GAOTINGXIANG/MYCLASS/DOC/中文字模生成指南.md

# 中文字模生成指南

> 工具：https://lvgl.io/tools/fontconverter
> 目标：生成 **一颗 14px 中文字模**（含 ASCII），替换现有 Montserrat 14/24，
> 覆盖当前 UI + 全部规划游戏名 + 常用界面词，共 **161 个汉字 + 3 个符号**。
> 预计 Flash 占用：14px @ bpp4 ≈ 110B/字 → 161 字约 **18KB**（裕量 778KB，毫无压力）。

## 1. 网页参数设置

| 字段 | 填什么 | 说明 |
| --- | --- | --- |
| Name | `lv_font_cn_14` | 生成的字体变量名，代码里按此名引用 |
| Size | `14` | 唯一字号，与当前正文一致 |
| Bpp | `4` | 16 级灰度抗锯齿；圆屏小字务必用 4，勿选 1/2（锯齿明显） |
| TTF | `C:\Windows\Fonts\simhei.ttf`（黑体） | ⚠️ 雅黑 `msyh.ttc` 和宋体 `simsun.ttc` 是 TTC 合集，网页工具**解析不了**；黑体是单文件 TTF，笔画均匀适合小屏。若追求开源授权可换"思源黑体 Regular" |
| Range | `0x20-0x7F` | 完整 ASCII（数字/字母/常用符号），使英文界面与中文同字体 |
| Symbols | 见下方"字符集"整段复制 | 所有汉字 + ℃ ° ： |

输出格式保持默认（LVGL C 文件），点 **Convert** 下载 `lv_font_cn_14.c`。

## 2. 字符集（Symbols 字段整段复制）

```
℃°：温湿度雷达钟表指南针系统信息游戏贪吃蛇打砖块结束你赢了按确认键开始北东西校准运行时间内存占用距离错误失败最高分得生命卡暂停继续退出设置难剩余重帮助于版本俄罗斯方块数字华容道小恐龙跳跃地鼠大鱼坦克射击飞黄金矿工切水果五子棋豆电脑马奥滑雪冒险铁跑酷狙外星旋转赛泡堂台球青蛙祖玛植物战僵尸保卫萝卜愤怒的鸟中国象棋羽毛火柴格斗冰菜
```

**覆盖清单**（缺字会显示方块，发现后把缺的字追加进 Symbols 重新生成即可）：

- 主菜单/游戏名：温湿度、雷达、钟表、指南针、系统、游戏、贪吃蛇、打砖块、
  俄罗斯方块、数字华容道、扫雷、小恐龙跳跃、打地鼠、大鱼吃小鱼、坦克射击、
  飞行射击、黄金矿工、切水果、五子棋、打豆豆、电脑鼠、
  马里奥、滑雪大冒险、地铁跑酷、狙击外星人、旋转赛车、泡泡堂、台球、
  青蛙祖玛、植物大战僵尸、保卫萝卜、愤怒的小鸟、中国象棋、羽毛球、
  火柴格斗、冰火人、种菜
- 界面提示：游戏结束、你赢了、按确认键开始、校准、错误、失败
- 标签词：温度、湿度、距离、运行时间、内存占用、最高分、得分、生命、
  关卡、暂停、继续、退出、设置、速度、难度、剩余、重开、帮助、关于、版本
- 方位：北、东、南、西
- 特殊符号：℃（温度单位）、°（指南针角度）、：（全角冒号）

## 3. 生成后接入步骤（我来执行）

1. `lv_font_cn_14.c` 放入 `LVGL_BSP/font/`，加入 Keil（LVGL_BSP 组）
2. 新建 `lv_font_cn.h`：`LV_FONT_DECLARE(lv_font_cn_14);`
3. `lv_conf.h`：
   - `LV_FONT_DEFAULT` → `&lv_font_cn_14`
   - `LV_FONT_MONTSERRAT_14` 置 0；`_24` 按实际情况（DEMO 组 demo_sensor.c 在用则保留）
   - `LV_USE_FONT_COMPRESSED` 置 1（在线工具默认压缩输出，否则黑屏）
   - `LV_USE_FONT_SUBPX` 置 1（生成时带亚像素/`--lcd` 则必须，否则文字不绘制）
4. 启动器等原 24px 大字处改为 `lv_font_cn_14`
   （视觉上变小；如需大字效果，可用 `lv_obj_set_style_transform_zoom(label, 512, 0)` 做 2 倍缩放，代价是像素感）
5. 字符串替换为中文，**含中文的 .c 文件必须保存为 UTF-8 with BOM**
   （Keil AC5 无 BOM 会按 GBK 解释，屏幕显示乱码）

## 4. 常见问题

| 现象 | 原因 / 处理 |
| --- | --- |
| 网页上传 TTF 报错 | 用了 .ttc 合集，换 simhei.ttf 或思源黑体 .otf/.ttf |
| 屏幕显示方块 | 该字不在 Symbols 里，把缺字追加后重新生成替换 .c |
| 屏幕显示乱码（全部中文） | 源文件不是 UTF-8 with BOM，用编辑器另存为带 BOM |
| 中文显示但英文变了 | 正常现象：英文数字也来自新字模，风格统一 |
| 编译报错 `struct "_lv_font_t" has no field "static_bitmap"` | 在线工具按新版 LVGL 生成，8.3 的 `lv_font_t` 无此字段，删除 `.static_bitmap = 0,` 一行即可 |
| 编译报错找不到 `lvgl/lvgl.h` | Keil AC5 不支持 `__has_include`，把字模头部的包含判断块整体改为 `#include "lvgl.h"` |
| **烧录后屏幕全黑，但蜂鸣/摇杆/编码器正常** | 字模是压缩格式（`.bitmap_format = 1`）而 `LV_USE_FONT_COMPRESSED = 0`，每个字符位图都返回 NULL → 全部跳过绘制。该宏置 1 即可；或重新生成时取消 Compress 并把宏改回 0 |
| 文字一律不绘制（图形正常） | 字模带亚像素（`--lcd`，`.subpx = LV_FONT_SUBPX_HOR`）而 `LV_USE_FONT_SUBPX = 0`；置 1 |
| 中文/英文有红蓝彩边 | 亚像素方向与屏幕 RGB 排列不匹配，翻转 `lv_conf.h` 的 `LV_FONT_SUBPX_BGR`（0↔1） |
| **Keil 报 `missing closing quote` 且字符串显示成 `灏忔亹榫欒烦璺?`** | 文件丢了 UTF-8 BOM（某些编辑/保存动作会剥掉 BOM），Keil 按 GBK 解释导致中文字符串被截断。重新另存为 **UTF-8 with BOM** 即可；**每次改完带中文的字符串都要复查 BOM** |

## 5. 缺失汉字清单（已补齐）

当前字模为一次性在线生成，**缺字会显示成方块**。发现缺字时，把下面的字追加到网页 **Symbols** 框，
重新 Convert 生成整颗字模替换 `LVGL_BSP/lv_font_cn_14.c` 即可（不要手工往 .c 里插字——三张表
`glyph_bitmap / glyph_dsc / unicode_list` 必须严格对齐，手工插字极易错位）。

> 核查时间 2026-11-01：新增「说明」栏目、「音效」开关，以及 9 个新游戏（大鱼小鱼/坦克射击/
> 黄金矿工/切水果/飞行射击/滑雪冒险/台球/地铁跑酷/狙击外星）后，重新扫描 `APP/*.c` 的全部
> 界面字符串（已排除注释），与现有字模 `unicode_list` 比对，**共 133 字缺失**。
>
> **2026-11-01 已补齐**：新生成字模（`unicode_list` 共 296 项）已替换 `LVGL_BSP/lv_font_cn_14.c`，
> 重新比对全部工程源码（244 个去重汉字）**缺字 0**。下面是当时的记录，留作以后补字参考。

### 5.1 一次性补字串（已并入新字模，留作记录）

```
一三上下不也人会传位作入关再减刀到刷刻加动十单即厘变可右同后向启周器回固声多完定左常平弹归彩快感或手才扣扫抓挥换掉推摆摇撞操效敌新明显朝机杆条枪树样模正每波洞清灯炮炸点照白盘瞄码碍碰示秒移空米类级编能自活落蜂补被说调起超越躲车轮近返进远速都钩锋锤长闭随障零静靠音页鸣默
```

### 5.2 逐字对照

| 来源 | 汉字（Unicode） |
| --- | --- |
| 「说明」菜单名 | 说(U+8BF4) 明(U+660E) |
| 说明·操作页 | 编(U+7F16) 码(U+7801) 器(U+5668) 摇(U+6447) 杆(U+6746) 左(U+5DE6) 右(U+53F3) 上(U+4E0A) 下(U+4E0B) 返(U+8FD4) 回(U+56DE) 一(U+4E00) 级(U+7EA7) 单(U+5355) 操(U+64CD) 作(U+4F5C) 同(U+540C) 样(U+6837) 进(U+8FDB) 入(U+5165) 换(U+6362) |
| 说明·指南针页 | 平(U+5E73) 模(U+6A21) 周(U+5468) 再(U+518D) 固(U+56FA) 定(U+5B9A) 朝(U+671D) 刻(U+523B) 盘(U+76D8) 随(U+968F) 位(U+4F4D) 动(U+52A8) 正(U+6B63) 蜂(U+8702) 鸣(U+9E23) 声(U+58F0) |
| 说明·小恐龙页 | 手(U+624B) 靠(U+9760) 近(U+8FD1) 超(U+8D85) 波(U+6CE2) 厘(U+5398) 米(U+7C73) 起(U+8D77) 到(U+5230) 才(U+624D) 能(U+80FD) 调(U+8C03) 速(U+901F) 加(U+52A0) 减(U+51CF) 推(U+63A8) 也(U+4E5F) |
| 说明·打地鼠页 | 传(U+4F20) 感(U+611F) 越(U+8D8A) 锤(U+9524) 移(U+79FB) 向(U+5411) |
| 说明·游戏页 | 类(U+7C7B) 或(U+6216) 灯(U+706F) 显(U+663E) 撞(U+649E) 扣(U+6263) 点(U+70B9) 归(U+5F52) 零(U+96F6) 即(U+5373) |
| 说明·音效页 | 音(U+97F3) 效(U+6548) 关(U+5173) 默(U+9ED8) 启(U+542F) 闭(U+95ED) 后(U+540E) 静(U+9759) 照(U+7167) 常(U+5E38) |
| 系统信息·音效行 | 音(U+97F3) 效(U+6548) 换(U+6362) 关(U+5173) 秒(U+79D2) |
| 小恐龙 HUD | 速(U+901F) |
| 「扫雷」菜单名 | 扫(U+626B) |
| 说明·大鱼小鱼页 | 三(U+4E09) 每(U+6BCF) 变(U+53D8) 长(U+957F) 碰(U+78B0) |
| 说明·坦克射击页 | 炮(U+70AE) 弹(U+5F39) 敌(U+654C) 被(U+88AB) |
| 说明·黄金矿工页 | 摆(U+6446) 钩(U+94A9) 抓(U+6293) 刷(U+5237) 完(U+5B8C) 新(U+65B0) |
| 说明·切水果页 | 刀(U+5200) 挥(U+6325) 锋(U+950B) 炸(U+70B8) 十(U+5341) 不(U+4E0D) 落(U+843D) |
| 说明·飞行射击页 | 机(U+673A) 自(U+81EA) |
| 说明·滑雪冒险页 | 树(U+6811) 躲(U+8EB2) 远(U+8FDC) 多(U+591A) |
| 说明·台球页 | 彩(U+5F69) 洞(U+6D1E) 白(U+767D) 瞄(U+7784) 可(U+53EF) 会(U+4F1A) 补(U+8865) 空(U+7A7A) 清(U+6E05) |
| 说明·地铁跑酷页 | 条(U+6761) 车(U+8F66) 轮(U+8F6E) 障(U+969C) 快(U+5FEB) 碍(U+788D) |
| 说明·狙击外星页 | 枪(U+67AA) 人(U+4EBA) 都(U+90FD) 掉(U+6389) |

> 注：旧记录曾把「雷」列为缺字，实际现有字模**已包含雷**（`unicode_list` 中偏移 0x9647 对应 U+96F7），
> 只有「扫」缺。若菜单显示「扫雷」时只有第一个字是方块，说明与此一致。

重新生成时把 5.1 整段粘贴进 Symbols，连同第 2 节已有字符一起生成，即可一次性补齐。
