GAOTINGXIANG/MYCLASS/DOC/游戏可行性评估.md

# 游戏可行性评估

> 评估对象：用户候选游戏清单（35 项，去重后）
> 硬件基线：STM32F407 @168MHz / 512KB Flash / 192KB RAM，240×240 圆屏（安全区为内接正方形 170×170，ORG=35），LVGL 8.3.11
> 输入：编码器（旋转+按键）、摇杆（模拟量+按键）、KEY1~KEY4、超声波 HC-SR04
> 输出：6×LED、蜂鸣器
> 框架：app_launcher（app_t 注册）+ game_common（生命值）+ sys_notify（声光）
> 美术约束：无图片素材，全部用几何图形 + 调色板表达

## 评估维度

1. **输入匹配**：编码器适合"光标/旋转/数值"，摇杆适合"方向/连续移动"，超声波适合"手势触发"
2. **屏幕适配**：网格类看格子能否放进 170×170；卷轴类看视野是否够用
3. **算力/内存**：F407 无压力于 2D 瓦片与简单物理；流体/刚体堆叠/复杂 AI 不行
4. **内容量**：几何风格能否表达玩法核心，是否需要大量剧情/素材
5. **框架契合**：能否直接挂 app_t，复用生命值/声光

---

## A 级：直接可做，适配良好

| 游戏 | 输入方案 | 布局 | 工作量 | 说明 |
|---|---|---|---|---|
| 俄罗斯方块 | 摇杆左右/下移，ENC 键旋转 | 10×20 格 @10px = 100×200 | 中 | 经典必做，圆屏竖向正好 |
| 2048 | 摇杆四方向滑动 | 4×4 @40px | 小 | 半天工作量，动画可省 |
| 数字华容道 | 摇杆滑动 / 编码器选格 | 4×4 @40px | 小 | 与 2048 同布局同输入 |
| 扫雷 | 编码器移光标，ENC 键翻开，KEY2 插旗 | 9×9 @16px | 小 | 编码器光标手感好 |
| **小恐龙跳跃** | **超声波：手一抬=跳**（距离突变检测） | 横版卷轴，几何仙人掌 | 小 | ⭐差异化亮点，输入创意 |
| **打地鼠** | **超声波：手拍下=锤**（距离变短触发） | 3×3 洞 @50px | 小 | ⭐差异化亮点 |
| 大鱼吃小鱼 | 摇杆游动 | 全屏水域 | 小 | 成长反馈好做（体型+LED） |
| 坦克射击 | 摇杆移动，JS 键开炮 | 12×12 tile @14px | 中 | 坦克大战简化版：砖墙+基地+3 种敌坦 |
| 飞行射击 | 摇杆移动，自动开火 | 纵版卷轴 | 中 | 雷霆战机简化：子弹池+敌机编队 |
| 黄金矿工 | 爪子自动摆动，任意键放爪 | 上爪下矿 | 中 | 简谐摆动+线段数学，物理简单 |
| 切水果 | 摇杆控制刀光轨迹 | 全屏 | 中 | 水果抛物线+线段切割判定 |
| 五子棋 | 编码器+摇杆选点，ENC 落子 | 13×13 @13px | 小(双人)/中(AI) | AI 用计分表即可，不求强 |
| 打豆豆 | 编码器选格，ENC 消除 | 8×8 @20px | 小 | 点击相邻同色消除 |
| **电脑鼠** | 自动走迷宫，编码器调速 | 16×16 迷宫 @10px | 中 | ⭐教学亮点：洪水填充算法可视化，契合课程主题 |
| 吃苹果的蛇 | — | — | — | ✅ 已完成（SNAKE） |

## B 级：可行，但需明显简化

| 游戏 | 简化方向 | 工作量 | 说明 |
|---|---|---|---|
| 马里奥 | 单屏平台跳或短卷轴，去精灵动画 | 中 | tilemap 碰撞是主要工作量 |
| 滑雪大冒险 | 与小恐龙共用横版引擎，下坡+跳障 | 中 | 做完小恐龙后顺手做 |
| 地铁跑酷 | 伪 3D 改俯视三跑道：左右变道+跳/滚 | 中 | 几何跑道透视可省略 |
| 狙击外星人 / 狙击小鬼子 | 合并为同一机制：摇杆准星+移动靶+KEY2 屏息 | 小~中 | 两者本质相同，建议用中性打靶/外星人主题 |
| 双飞旋转赛车 | 环形俯视跑道，编码器=方向盘 | 中 | 编码器控制转向是绝配 |
| 泡泡堂 | 单人炸箱子+1 个 AI 敌人 | 中 | 网格+爆炸十字判定 |
| 台球 | 简化圆-圆碰撞+摩擦，编码器调杆角 | 中 | 不做旋转球，只做分离角 |
| 青蛙祖玛 | 贝塞尔轨道+球链插入消除 | 中大 | 球链数据结构是难点 |
| 植物大战僵尸 | 3 行极简版，3 种植物 2 种僵尸 | 中大 | 保留"种植物-产阳光-防线"核心 |
| 保卫萝卜 | 单一路径+3 种塔 | 中大 | 与上者二选一即可 |
| 愤怒的小鸟 | 保留抛物线，方块只做命中判定不做倒塌 | 中 | 编码器调角度，KEY2 蓄力 |
| 中国象棋 | 双人对战，不做 AI | 中 | 棋盘 18px 格偏挤但可用；AI 在 F407 上只能极浅搜索，不建议 |
| 羽毛球 | 改单人颠球/人机对打 | 中 | 双人输入不够分 |
| 格斗（火柴人） | 改单人闯关，招式简化为 3 键 | 大 | 动画状态机工作量大 |
| 冰火人 | 改单人切换双角色解谜，单屏关卡 | 中大 | 双人操作输入不够分 |
| 种菜 / Tom 猫 | 需内部 Flash 或 RTC 备份域存档 | 大 | 掉电丢档则玩法不成立；圆屏表现力弱，不建议优先 |

## C 级：不建议

| 游戏 | 原因 |
|---|---|
| 小鳄鱼爱洗澡 | 流体物理（挖土引水）在 168MHz 上算不动，240px 也表现不出 |
| 老爹汉堡店 | 经营类 UI 密集，多工位在 240 圆屏摆不下 |
| 赵云与阿斗 | RPG 内容量（剧情/精灵/关卡）远超几何风格能承载 |
| 打屁股 | 机制与打地鼠完全相同，作为其皮肤合并即可 |

---

## 结论与建议

### 最推荐（差异化 + 工作量小）

1. **小恐龙跳跃（超声波跳）**——输入创意，评委/同学一眼记住
2. **打地鼠（超声波锤）**——同上，互动性最强
3. **俄罗斯方块**——经典完成度高，必做
4. **坦克射击**——摇杆+按键组合最爽快的动作游戏
5. **电脑鼠**——算法可视化，与课程项目气质最搭

### 开发顺序建议

1. 先做 **2048 / 数字华容道 / 扫雷**（纯网格逻辑，各约半天，快速扩充游戏列表）
2. 再做 **小恐龙 / 打地鼠**（超声波交互，需把 HC-SR04 采样从 250ms 提到 60~100ms——游戏内直接调驱动，不走 sys_sensor 节流）
3. 然后 **俄罗斯方块 / 大鱼吃小鱼**（中等工作量）
4. 最后挑 **坦克射击 / 飞行射击**（动作类收尾）

### 通用约定（新游戏直接沿用）

- 输入映射：编码器=光标/旋转/数值，摇杆=方向/移动，ENC 键+JS 键=确认，KEY1=返回，KEY2/KEY3=功能键
- 生命值/提示音：复用 `game_common` + `sys_notify`，不要在游戏里直接驱动 LED/蜂鸣器
- 布局：优先使用内接正方形 ORG=35、170×170；需要满屏的游戏注意圆角裁剪，关键信息别放四角
- 中文显示：菜单名与提示语走中文字模方案（见另一文档），游戏内部画面以图形为主、文字最少化
