GAOTINGXIANG/MYCLASS/Core/Src/main.c

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
/* Includes ------------------------------------------------------------------*/
#include "main.h"
#include "cmsis_os.h"
#include "adc.h"
#include "dma.h"
#include "i2c.h"
#include "spi.h"
#include "tim.h"
#include "gpio.h"

/* USER CODE BEGIN Includes */
#include "gc9a01.h"
#include "joystick.h"
#include "led.h"
#include "hcsr04.h"
#include "beep.h"
#include "dht11.h"
#include "encoder.h"
#include "hmc5883l.h"
#include "joystick_lcd_demo.h"
/* USER CODE END Includes */


void SystemClock_Config(void);
void MX_FREERTOS_Init(void);
/* USER CODE BEGIN 0 */
volatile int hcsr_state=-1;

/* USER CODE END 0 */

/**
  * @brief  The application entry point.
  * @retval int
  */
int main(void)
{

  /* MCU Configuration--------------------------------------------------------*/

  /* Reset of all peripherals, Initializes the Flash interface and the Systick. */
  HAL_Init();

  /* Configure the system clock */
  SystemClock_Config();

  /* Initialize all configured peripherals */
  MX_GPIO_Init();
  MX_DMA_Init();
  MX_ADC1_Init();
  MX_SPI1_Init();
  MX_TIM4_Init();
  MX_TIM5_Init();
  MX_I2C2_Init();
  /* USER CODE BEGIN 2 */
gc9a01_init();
joy_init(); 
led_init();
hcsr04_init();
dht11_init();
encoder_init();
hmc5883l_init();

  /* USER CODE END 2 */

  /* Init scheduler */
  osKernelInitialize();  /* Call init function for freertos objects (in cmsis_os2.c) */
  MX_FREERTOS_Init();

  /* Start scheduler */
  osKernelStart();

  /* We should never get here as control is now taken by the scheduler */

  /* Infinite loop */
  /* USER CODE BEGIN WHILE */
  while (1)
  {
    /* USER CODE END WHILE */

    /* USER CODE BEGIN 3 */
  }
  /* USER CODE END 3 */
}

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
