GAOTINGXIANG/MYCLASS/Core/Inc/main.h

#define JS_VRy_Pin GPIO_PIN_1
#define JS_VRy_GPIO_Port GPIOC
#define JS_VRx_Pin GPIO_PIN_3
#define JS_VRx_GPIO_Port GPIOC
#define ENCODER_B_Pin GPIO_PIN_0
#define ENCODER_B_GPIO_Port GPIOA
#define ENCODER_A_Pin GPIO_PIN_1
#define ENCODER_A_GPIO_Port GPIOA
#define LCD_LED_Pin GPIO_PIN_2
#define LCD_LED_GPIO_Port GPIOA
#define LCD_SCK_Pin GPIO_PIN_5
#define LCD_SCK_GPIO_Port GPIOA
#define LCD_SDA_Pin GPIO_PIN_7
#define LCD_SDA_GPIO_Port GPIOA
#define KEY1_Pin GPIO_PIN_5
#define KEY1_GPIO_Port GPIOC
#define KEY2_Pin GPIO_PIN_1
#define KEY2_GPIO_Port GPIOB
#define LCD_A0_Pin GPIO_PIN_7
#define LCD_A0_GPIO_Port GPIOE
#define KEY3_Pin GPIO_PIN_8
#define KEY3_GPIO_Port GPIOE
#define LCD_RES_Pin GPIO_PIN_9
#define LCD_RES_GPIO_Port GPIOE
#define KEY4_Pin GPIO_PIN_10
#define KEY4_GPIO_Port GPIOE
#define LCD_CS_Pin GPIO_PIN_11
#define LCD_CS_GPIO_Port GPIOE
#define MAG_READY_Pin GPIO_PIN_14
#define MAG_READY_GPIO_Port GPIOE
#define MAG_SCL_Pin GPIO_PIN_10
#define MAG_SCL_GPIO_Port GPIOB
#define MAG_SDA_Pin GPIO_PIN_11
#define MAG_SDA_GPIO_Port GPIOB
#define BEEP_Y_Pin GPIO_PIN_12
#define BEEP_Y_GPIO_Port GPIOB
#define JS_KEY_Pin GPIO_PIN_9
#define JS_KEY_GPIO_Port GPIOD
#define DHT11_DATA_Pin GPIO_PIN_6
#define DHT11_DATA_GPIO_Port GPIOC
#define LED6_Pin GPIO_PIN_7
#define LED6_GPIO_Port GPIOC
#define LED1_Pin GPIO_PIN_9
#define LED1_GPIO_Port GPIOC
#define LED5_Pin GPIO_PIN_8
#define LED5_GPIO_Port GPIOA
#define LED3_Pin GPIO_PIN_11
#define LED3_GPIO_Port GPIOC
#define LED2_Pin GPIO_PIN_12
#define LED2_GPIO_Port GPIOC
#define LED4_Pin GPIO_PIN_0
#define LED4_GPIO_Port GPIOD
#define ENCODER_KEY_Pin GPIO_PIN_3
#define ENCODER_KEY_GPIO_Port GPIOD
#define US_Echo_Pin GPIO_PIN_7
#define US_Echo_GPIO_Port GPIOB
#define US_Trig_Pin GPIO_PIN_9
#define US_Trig_GPIO_Port GPIOB
