GAOTINGXIANG/MYCLASS/LVGL_BSP/lv_font_cn_14 _2.c

/*******************************************************************************
 * Size: 14 px
 * Bpp: 4
 * Opts: --bpp 4 --size 14 --lcd --use-color-info --stride 1 --align 1 --font simhei.ttf --symbols ℃°：温湿度雷达钟表指南针系统信息游戏贪吃蛇打砖块结束你赢了按确认键开始北东西校准运行时间内存占用距离错误失败最高分得生命卡暂停继续退出设置难剩余重帮助于版本俄罗斯方块数字华容道小恐龙跳跃地鼠大鱼坦克射击飞黄金矿工切水果五子棋豆电脑马奥滑雪冒险铁跑酷狙外星旋转赛泡堂台球青蛙祖玛植物战僵尸保卫萝卜愤怒的鸟中国象棋羽毛火柴格斗冰菜一三上下不也人会传位作入关再减刀到刷刻加动十单即厘变可右同后向启周器回固声多完定左常平弹归彩快感或手才扣扫抓挥换掉推摆摇撞操效敌新明显朝机杆条枪树样模正每波洞清灯炮炸点照白盘瞄码碍碰示秒移空米类级编能自活落蜂补被说调起超越躲车轮近返进远速都钩锋锤长闭随障零静靠音页鸣默 --range 32-127 --format lvgl -o lv_font_cn_14.c
 ******************************************************************************/

#ifdef __has_include
    #if __has_include("lvgl.h")
        #ifndef LV_LVGL_H_INCLUDE_SIMPLE
            #define LV_LVGL_H_INCLUDE_SIMPLE
        #endif
    #endif
#endif

#ifdef LV_LVGL_H_INCLUDE_SIMPLE
    #include "lvgl.h"
#else
    #include "lvgl/lvgl.h"
#endif



#ifndef LV_FONT_CN_14
#define LV_FONT_CN_14 1
#endif

#if LV_FONT_CN_14

/*-----------------
 *    BITMAPS
 *----------------*/

/*Store the image of the glyphs*/
static LV_ATTRIBUTE_LARGE_CONST const uint8_t glyph_bitmap[] = {
    /* U+0020 " " */

    /* U+0021 "!" */
    0x4, 0x8d, 0xd5, 0x30, 0x80, 0x44, 0x53, 0x0,
    0x71, 0x88, 0x39, 0x88, 0x1, 0xc4, 0x0, 0x20,
    0x18, 0x7c, 0xc0, 0xc4, 0x2, 0x30, 0x11, 0x3,
    0x80, 0x42, 0x27, 0x31, 0x10, 0x6, 0x31, 0x17,
    0x80, 0x72, 0xd6, 0x39, 0x0, 0x48, 0xf7, 0x69,
    0x51, 0x0, 0x16, 0x22, 0x44, 0x60,

    /* U+0022 "\"" */
    0x3, 0x8e, 0xfa, 0x50, 0x5b, 0xfd, 0x82, 0x0,
    0xf, 0x91, 0x4e, 0x2, 0x40, 0xda, 0x40, 0x3,
    0x10, 0x1f, 0x30, 0x70, 0x21, 0x10, 0x4, 0x2d,
    0x98, 0x71, 0x3, 0x9d, 0xa4, 0x0, 0x0,

    /* U+0023 "#" */
    0x0, 0xfc, 0x4f, 0x96, 0xc2, 0x0, 0x27, 0xcb,
    0x61, 0x0, 0xff, 0xf, 0x8, 0x88, 0x40, 0x3,
    0xc2, 0x22, 0x10, 0xf, 0xf3, 0x10, 0x13, 0x0,
    0x4c, 0x60, 0x4e, 0x1, 0xe6, 0xbf, 0xfa, 0x90,
    0x9f, 0x7f, 0xea, 0x52, 0x7c, 0xd8, 0x30, 0x9,
    0xab, 0x75, 0x2a, 0x2b, 0x3b, 0xb4, 0xa8, 0xac,
    0xef, 0xc9, 0x80, 0x61, 0x23, 0x6, 0x2d, 0x42,
    0x21, 0x83, 0x16, 0xa1, 0x10, 0x40, 0x32, 0xd7,
    0xf4, 0x99, 0xa3, 0x7f, 0xdd, 0x26, 0x68, 0xdf,
    0xd8, 0x30, 0x9, 0x6f, 0x61, 0x5, 0xaf, 0x76,
    0x94, 0x16, 0xbd, 0xd7, 0xc9, 0x80, 0x61, 0x30,
    0x72, 0xf5, 0x22, 0x18, 0xb9, 0x7a, 0x91, 0x42,
    0x1, 0xe2, 0xe1, 0x62, 0x10, 0x1, 0x78, 0xb1,
    0x88, 0x7, 0x0,

    /* U+0024 "$" */
    0x0, 0xfc, 0x4a, 0xc6, 0x1, 0xff, 0xc5, 0x7f,
    0xa4, 0x10, 0xf, 0xf8, 0x4d, 0xef, 0x6d, 0x4e,
    0x3f, 0x25, 0x4, 0x3, 0xc7, 0x3d, 0x21, 0x72,
    0x86, 0xcc, 0x77, 0x54, 0x20, 0x7, 0x31, 0x91,
    0x31, 0x8, 0x43, 0xab, 0xe5, 0x44, 0x60, 0xc,
    0xf8, 0x47, 0x57, 0x8c, 0x0, 0x34, 0x7b, 0x85,
    0x10, 0xc, 0x4f, 0xf4, 0x88, 0x63, 0x2c, 0x63,
    0x10, 0xf, 0xf1, 0x2c, 0xed, 0x28, 0x24, 0x66,
    0x29, 0x44, 0x3, 0x9, 0x22, 0x8, 0x40, 0x22,
    0x8b, 0x71, 0x58, 0x92, 0x0, 0x8a, 0xa6, 0xe5,
    0x0, 0x39, 0x71, 0x44, 0xc4, 0x40, 0x11, 0xe2,
    0xa, 0xf3, 0x90, 0x87, 0x37, 0x20, 0xae, 0x10,
    0x6, 0x48, 0xa6, 0x9, 0x84, 0x36, 0x96, 0x4a,
    0x95, 0x10, 0xe, 0x14, 0x8b, 0xea, 0x53, 0x8f,
    0xc9, 0x52, 0x0, 0xff, 0xe0, 0x3f, 0xd2, 0x8,
    0x7, 0xe0,

    /* U+0025 "%" */
    0x0, 0xff, 0xe1, 0x88, 0xc0, 0x18, 0xdf, 0x37,
    0xb2, 0x10, 0x3, 0x96, 0x58, 0xc0, 0x24, 0xaa,
    0x2c, 0xea, 0x2f, 0x28, 0x0, 0x5b, 0x79, 0x88,
    0x2, 0x13, 0x1, 0x71, 0xf0, 0x13, 0x2, 0x6e,
    0xd6, 0x10, 0xc, 0x26, 0x2, 0xe3, 0xc0, 0x26,
    0x8a, 0x16, 0xa0, 0x1e, 0x4a, 0xa1, 0x4f, 0x12,
    0xf1, 0xe0, 0x29, 0x80, 0x7e, 0x37, 0xbd, 0xd5,
    0xc9, 0x77, 0x11, 0xeb, 0x37, 0x25, 0x44, 0x3,
    0xe3, 0x6e, 0xd5, 0x49, 0x1a, 0xeb, 0x59, 0x71,
    0x0, 0xe4, 0x40, 0x62, 0x87, 0x88, 0x8c, 0xc4,
    0xe3, 0xc6, 0x1, 0xa, 0xe0, 0x2a, 0x0, 0xf8,
    0x9, 0x91, 0xb8, 0xf9, 0x80, 0x5, 0xcb, 0x98,
    0x80, 0x4, 0xb6, 0x17, 0x96, 0xd2, 0xc2, 0x0,
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
    0x97, 0xae, 0x40, 0x1f, 0x8e, 0x32, 0x9d, 0xd5,
    0x98, 0x95, 0x20, 0xe, 0x14, 0x9e, 0xdb, 0x97,
    0x5a, 0xdc, 0x84, 0x10, 0xf, 0xfe, 0x0, 0xad,
    0x65, 0xb3, 0xba, 0xb7, 0x18, 0x80, 0x2, 0x91,
    0xb7, 0x9f, 0x90, 0xa4, 0x1, 0xff, 0xc7, 0x14,
    0x8b, 0xfd, 0xce, 0x62, 0x0, 0x0,
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
