GAOTINGXIANG/MYCLASS/APP/app_help.h

#ifndef __APP_HELP_H
#define __APP_HELP_H

#ifdef __cplusplus
extern "C" {
#endif

#include "app_launcher.h"

/* 说明 app：分页展示各 APP 的使用方法 */
extern const app_t app_help;

#ifdef __cplusplus
}
#endif

#endif /* __APP_HELP_H */
