GAOTINGXIANG/MYCLASS/LVGL_BSP/lv_font_cn.h

/**
 * @file lv_font_cn.h
 * @brief 中文字模声明：14px 黑体（含 ASCII），全项目唯一字体。
 *   字模由 https://lvgl.io/tools/fontconverter 生成（lv_font_cn_14.c）。
 */
#ifndef LV_FONT_CN_H
#define LV_FONT_CN_H

#include "lvgl.h"

LV_FONT_DECLARE(lv_font_cn_14);

#endif /* LV_FONT_CN_H */
