GAOTINGXIANG/MYCLASS/(commit log)

2026-10-25 新建工程
2026-10-25 测试一次代码
2026-10-25 添加超声波模块驱动
2026-10-27 补提交26号的修改记录,硬件上修复5V和3.3V的短接问题,修复LED,超声波地没有与407供地的问题,证明软件无误,调整摇杆的X,Y轴为正确方向,编写了一个demo用来演示摇杆与LCD联动
2026-11-01 增加lvgl库,增加指南针驱动以及效果演示,新建声光演示以及传感器任务
    [code-format.cfg]
2026-11-01 fix:去除超声波无人检测,修复蜂鸣器长响
2026-11-01 feat:改成中文显示
2026-11-01 改成中文显示
2026-11-01 feat:新增lience
2026-11-01 fix:修复因LVGL版本差异导致的中文不显示
2026-11-01 feat:添加流水灯效果
2026-11-01 feat:实现 5 个 A 级网格/棋盘类游戏（2048、数字华容道、五子棋、打豆豆、俄罗斯方块）
2026-11-01 feat:添加扫雷游戏,雷字还待buchong
2026-11-01 feat:添加剩余的三个按键作为选项
2026-11-01 feat:小恐龙和打地鼠游戏中加入其他输入接口
2026-11-01 feat:优化控制手感,新增说明板块
2026-11-01 feat:添加一系列游戏
2026-11-01 feat:补齐缺失的字
2026-11-01 feat:添加readme
2026-11-02 feat:添加了一个二维码,微调了readme
